Thecactusman0/Music32-V3/Music32v3/3D models/Batt connector.step

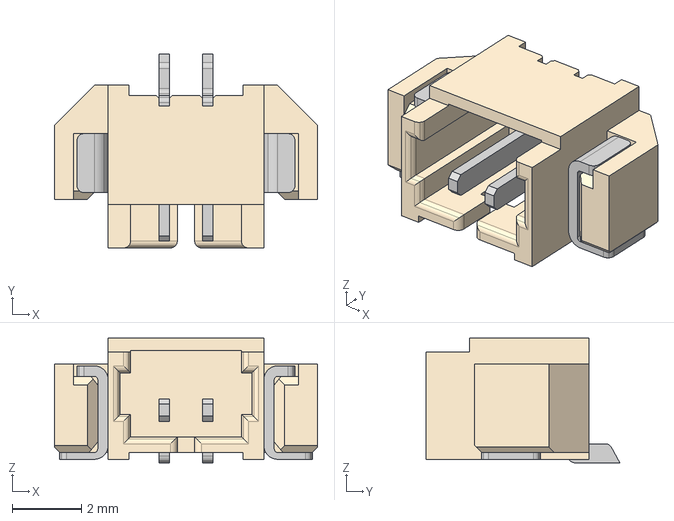
[picture p1: CAD file, 2023-12-19]
Music32v3/3D models/Batt connector.step
7.60 x 5.60 x 3.60 mm
