Thecactusman0/Music32-V3/Music32v3/3D models/srgp400200 copy.stp

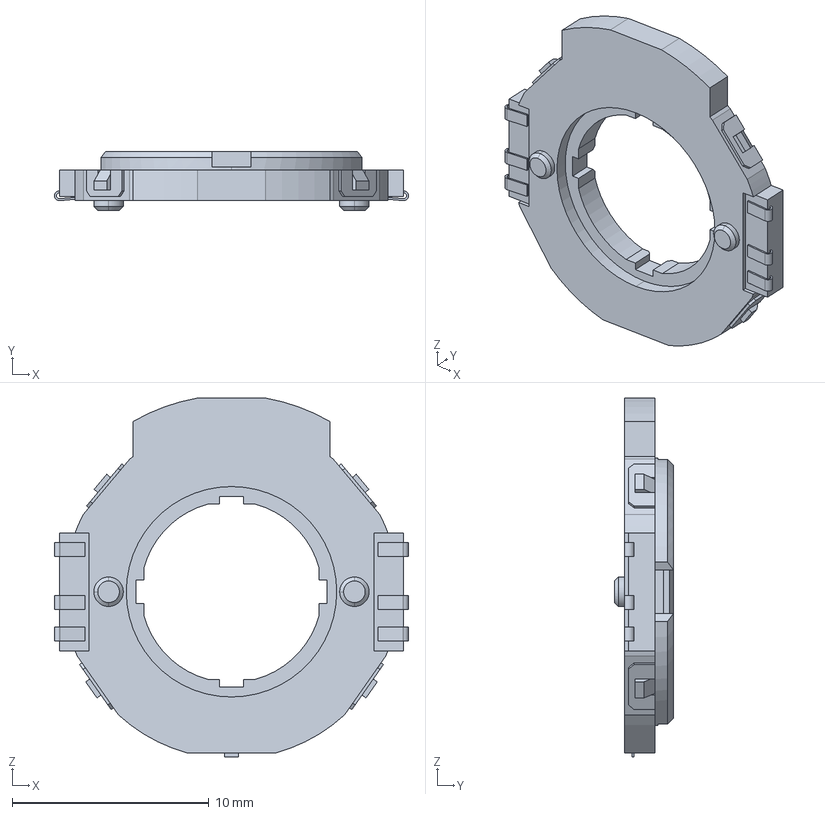
[picture p2: CAD file, 2023-12-19]
Music32v3/3D models/srgp400200 copy.stp
18.0 x 3.00 x 18.2 mm
