Thecactusman0/Music32-V3/Music32v3/3D models/TS3315A.step

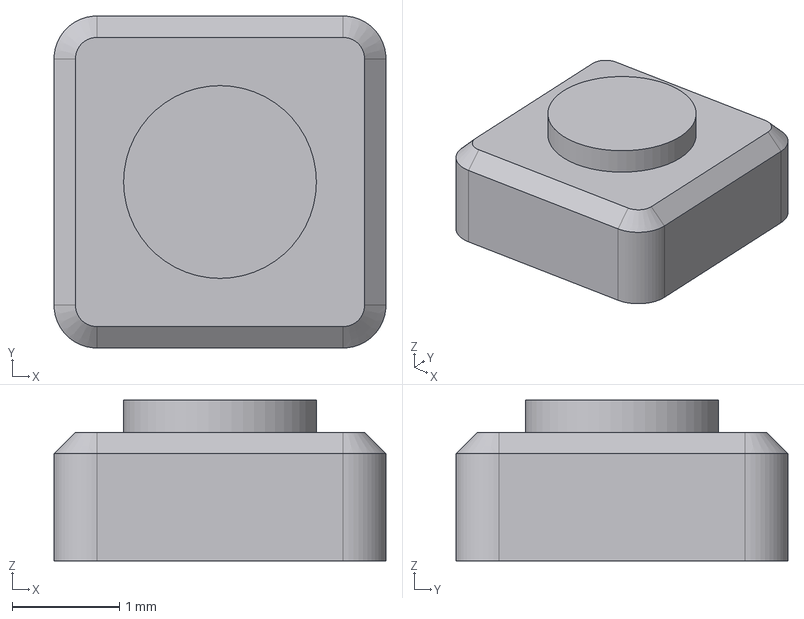
[picture p3: CAD file, 2023-11-29]
Music32v3/3D models/TS3315A.step
3.10 x 3.10 x 1.50 mm
