Thecactusman0/Music32-V3/Music32v3/3D models/TSA002A3816B04.step

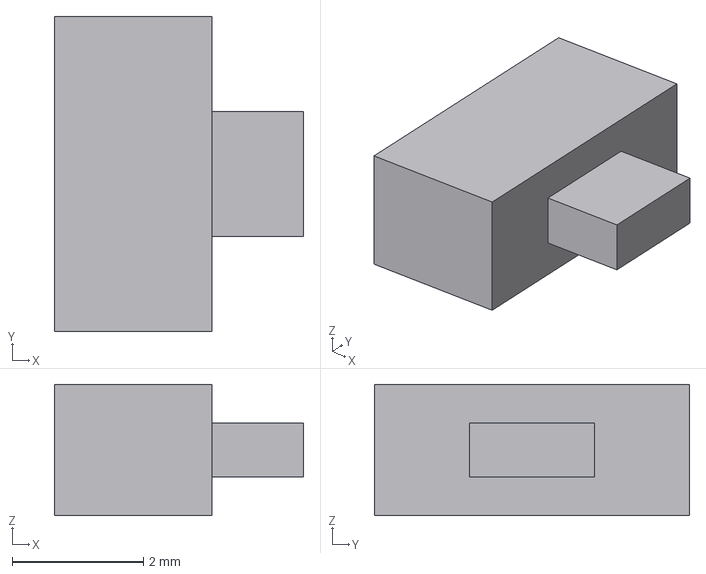
[picture p4: CAD file, 2023-11-29]
Music32v3/3D models/TSA002A3816B04.step
3.80 x 4.80 x 2.00 mm
