Thecactusman0/Music32-V3/Music32v3/3D models/2” lcd without the cable.step

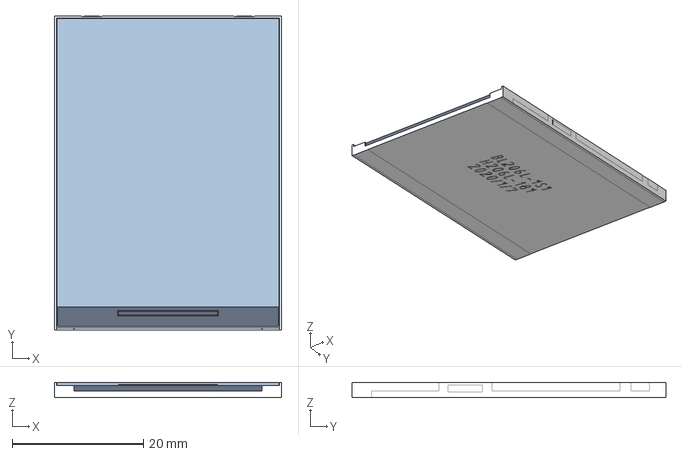
[picture p5: CAD file, 2023-11-25]
Music32v3/3D models/2” lcd without the cable.step
34.6 x 47.8 x 2.30 mm
2.0 TFT IPS - 12P - Reverse Mount - With Glass
2.0 TFT IPS - 12P - Reverse Mount - Glass
