Thecactusman0/Music32-V3/Music32v3/3D models/GMI4015P-2C-66db.step

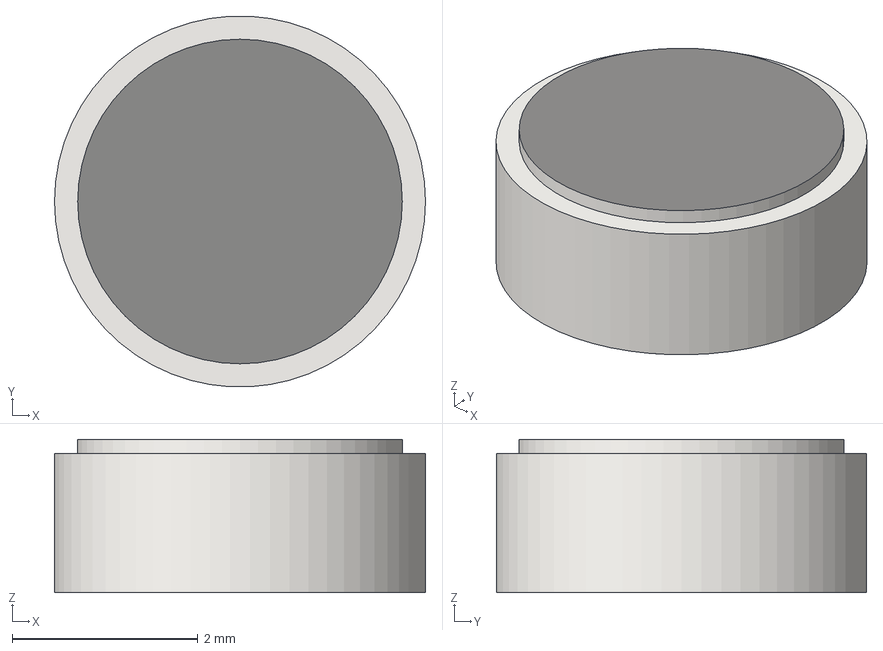
[picture p6: CAD file, 2023-11-25]
Music32v3/3D models/GMI4015P-2C-66db.step
4.00 x 3.99 x 1.65 mm
