Thecactusman0/Music32-V3/Music32v3/3D models/2.0 TFT IPS - 12P - Reverse Mount - With Glass.stp

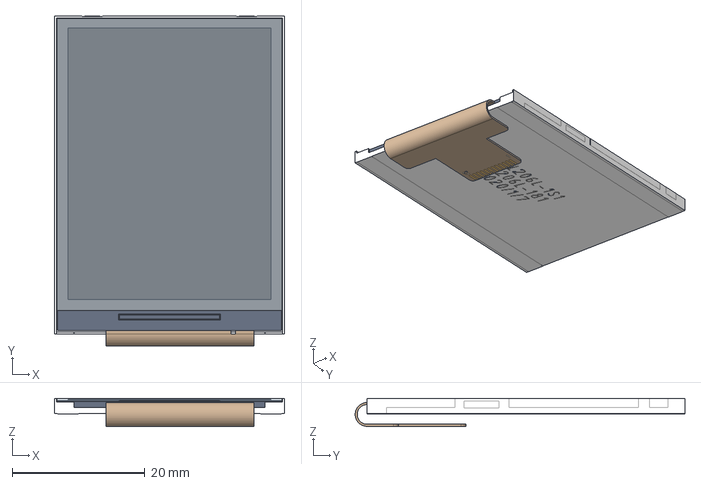
[picture p7: CAD file, 2023-11-25]
Music32v3/3D models/2.0 TFT IPS - 12P - Reverse Mount - With Glass.stp
34.6 x 49.6 x 4.22 mm
2.0 TFT IPS - 12P - Reverse Mount - With Glass
2.0 TFT IPS - 12P - Reverse Mount - Glass
