Thecactusman0/Music32-V3/Music32v3/3D models/Audio socket.step

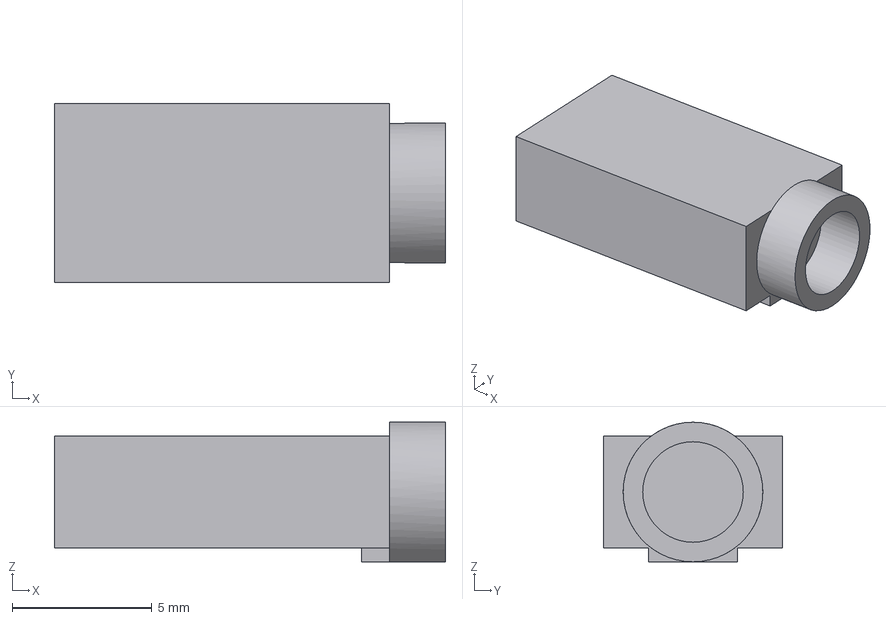
[picture p8: CAD file, 2023-11-25]
Music32v3/3D models/Audio socket.step
14.0 x 6.40 x 5.00 mm
