Thecactusman0/Music32-V3/Music32v3/3D models/SK-3393M-G1.step

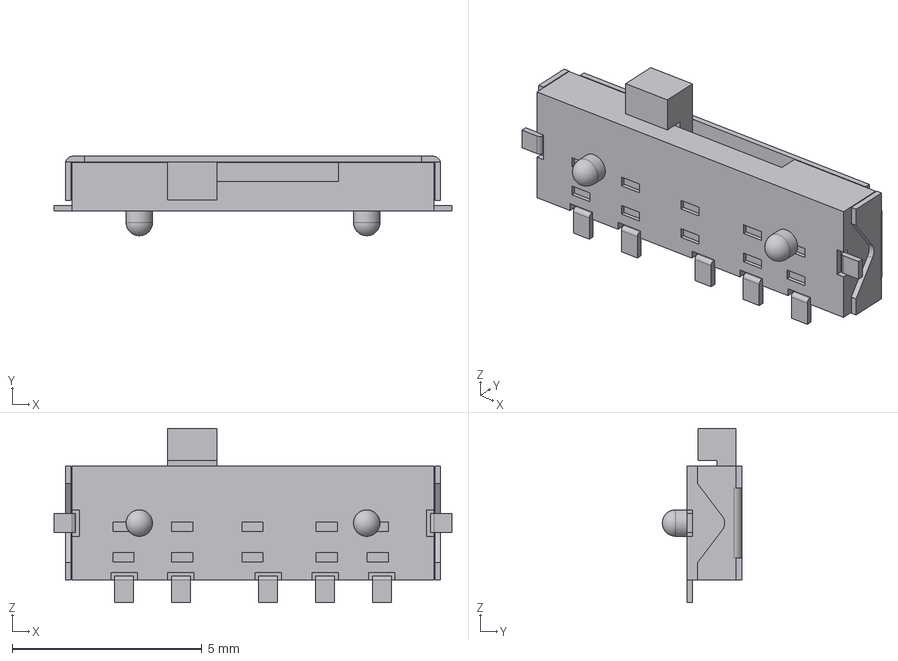
[picture p9: CAD file, 2023-11-25]
Music32v3/3D models/SK-3393M-G1.step
10.5 x 2.10 x 4.60 mm
