Thecactusman0/Music32-V3/Music32v3/3D models/u262-16xn-4bvc11.stp

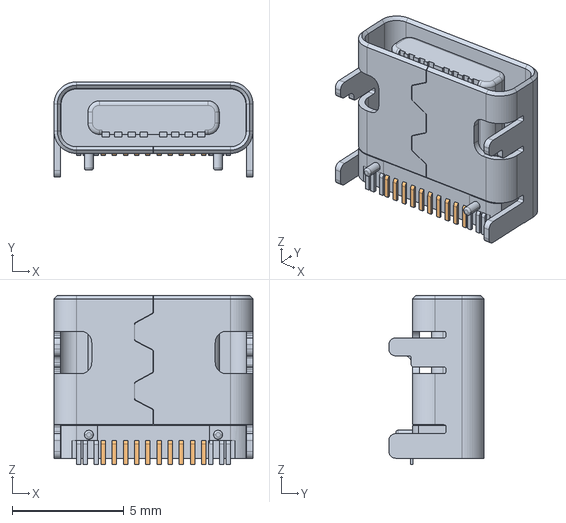
[picture p10: CAD file, 2023-11-25]
Music32v3/3D models/u262-16xn-4bvc11.stp
8.90 x 4.26 x 7.56 mm
