Thecactusman0/Music32-V3/Music32v3/3D models/ESP32-WROOM-32E.step

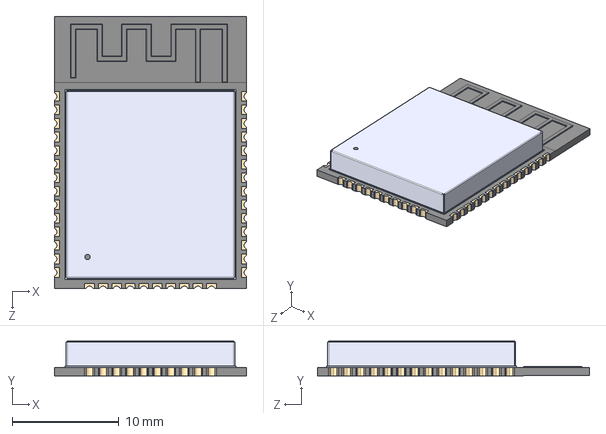
[picture p11: CAD file, 2023-11-21]
Music32v3/3D models/ESP32-WROOM-32E.step
18.0 x 3.25 x 25.5 mm
