Thecactusman0/Music32-V3/Music32v3/3D models/503398-1892.step

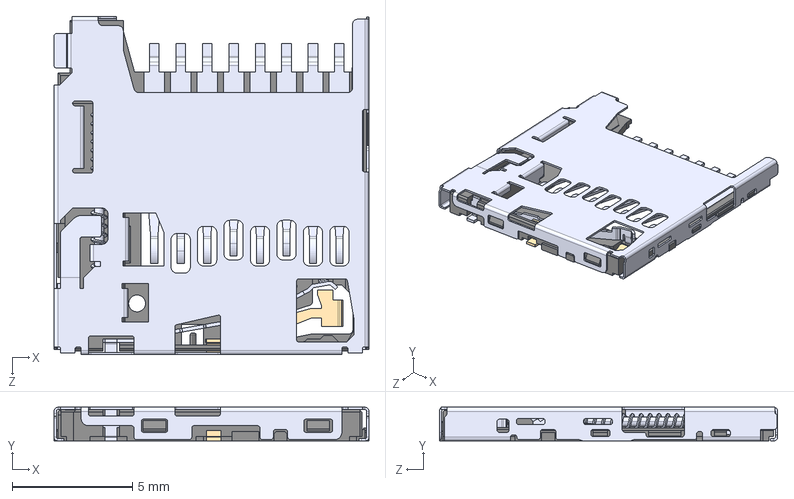
[picture p12: CAD file, 2023-11-27]
Music32v3/3D models/503398-1892.step
13.1 x 1.40 x 14.1 mm
