Thecactusman0/Music32-V3/Music32v3/3D models/MAX17048G+.STEP

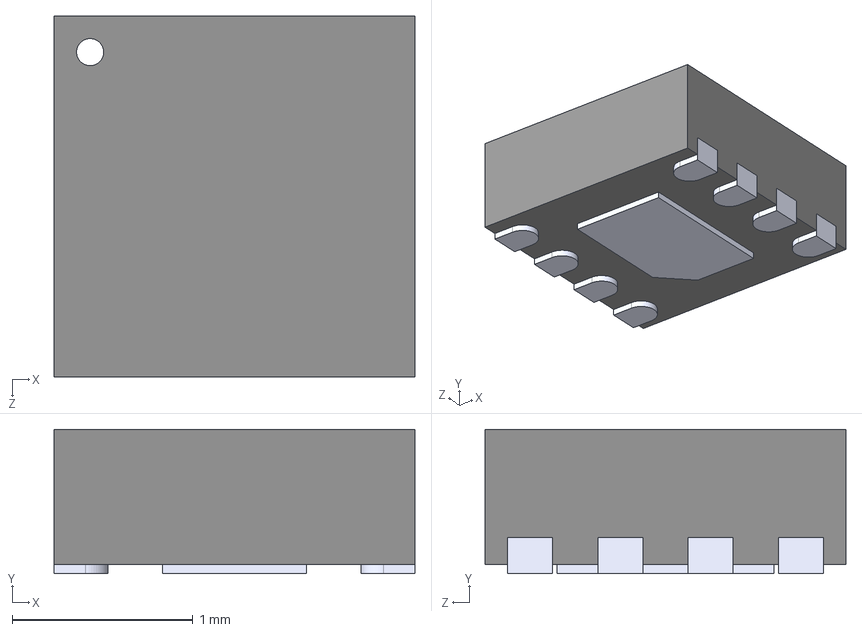
[picture p13: CAD file, 2023-11-25]
Music32v3/3D models/MAX17048G+.STEP
2.00 x 0.8 x 2.00 mm
