Thecactusman0/Music32-V3/(list of files, cad)

Other CAD files:
Music32v3/3D models/Encoder v3.step
Music32v3/3D models/Encoder.stl
