Thecactusman0/Music32-V3/Music32v3/Music32v3.pdf

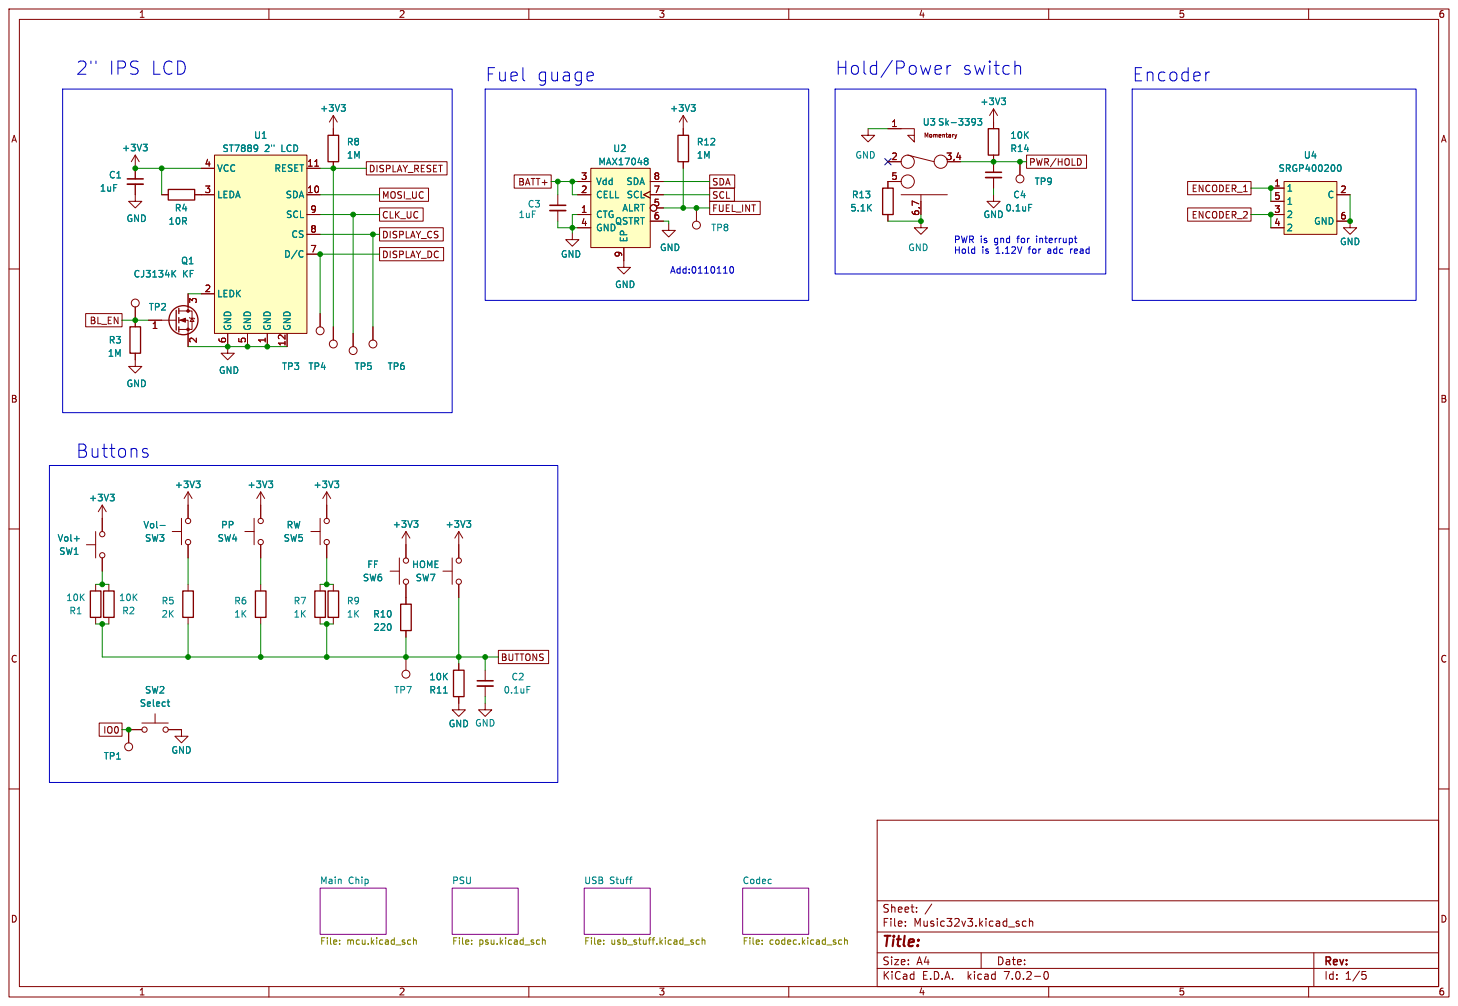
[picture p14: page 1]

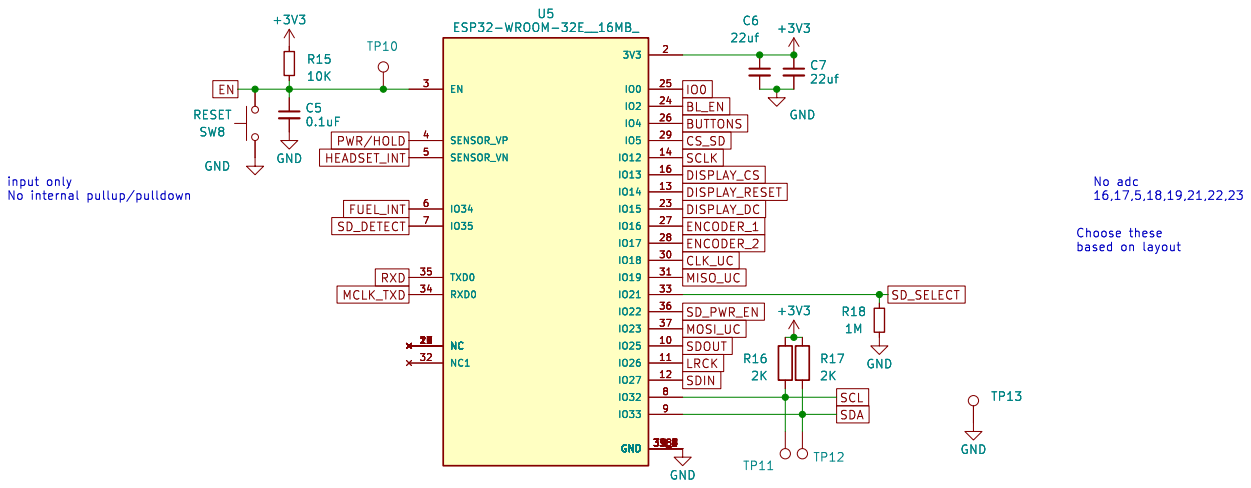
[picture p15: page 2]

based on layout GND

Id: 2/5 Title: File: mcu.kicad_sch Sheet: /Main Chip/

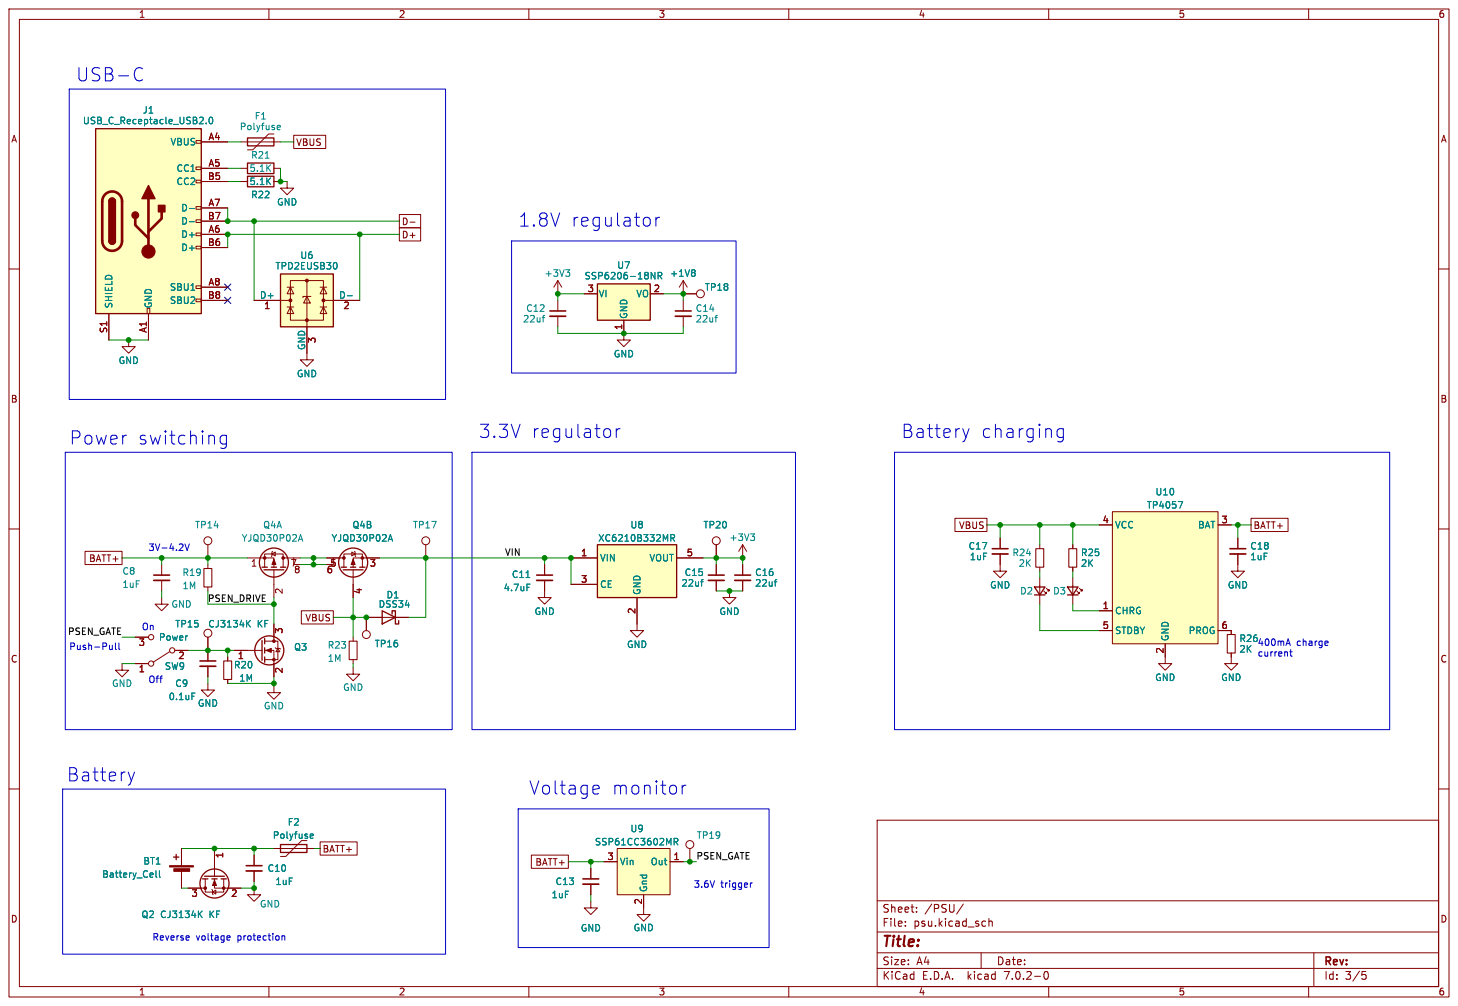
[picture p16: page 3]

2 BAT 3 VCC 4 STDBY 5 PROG 6 U10 TP4057 R26

2 BAT 3 VCC 4 STDBY 5 PROG 6GND

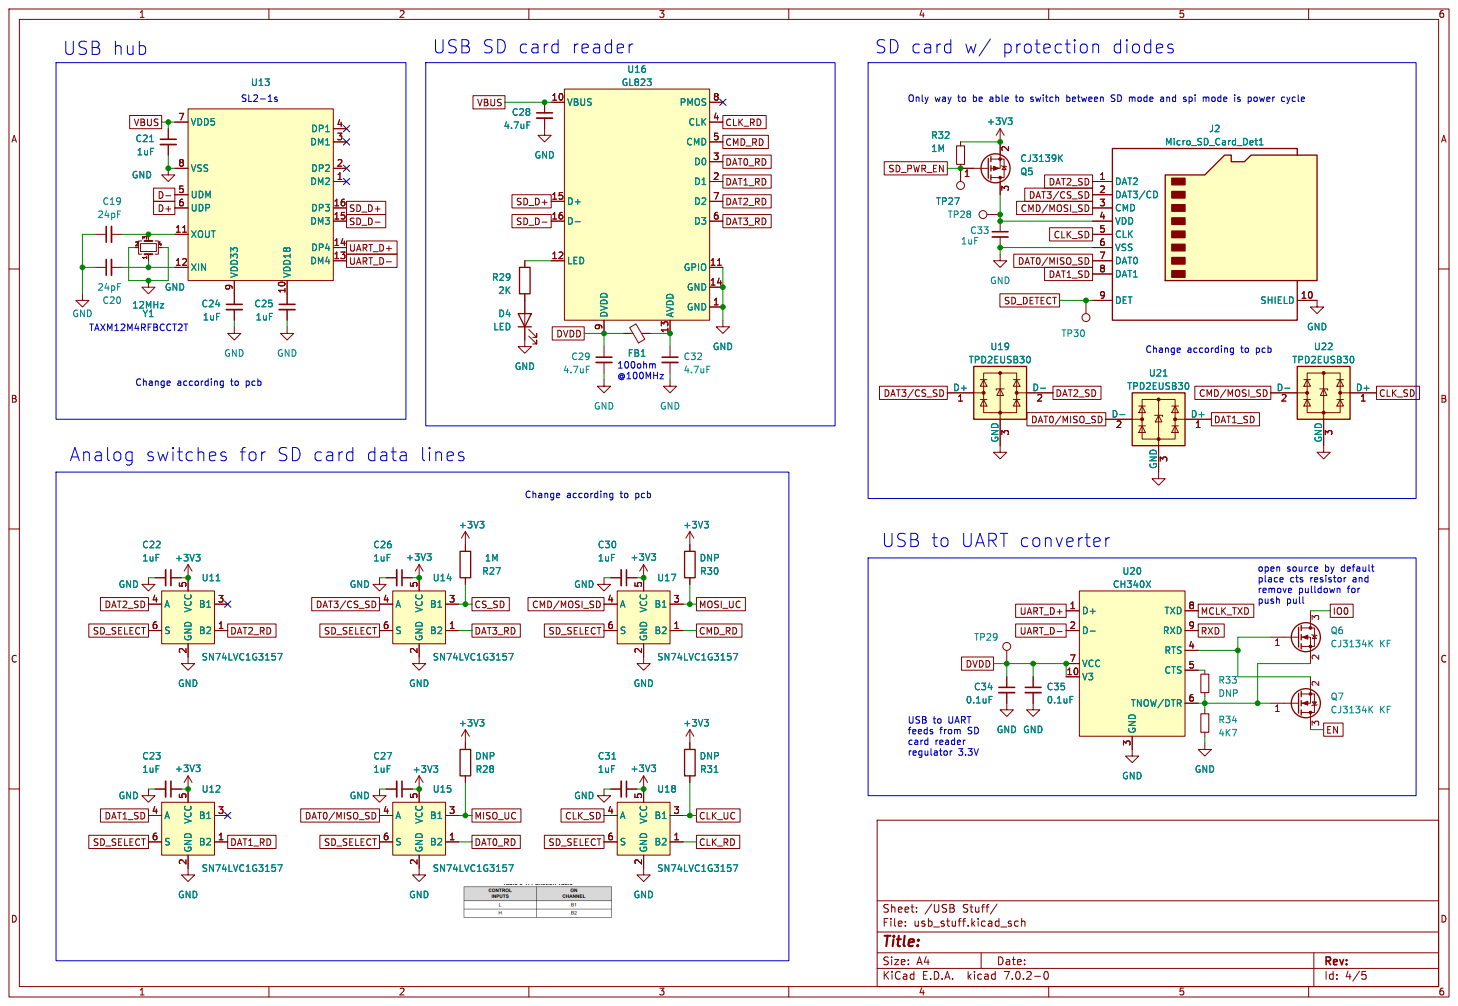
[picture p17: page 4]

DAT1_SD Only way to be able to switch between SD mode and spi mode is power cycle

Analog switches for SD card data lines

USB to UART converter

3 RTS 4 CTS 5 TNOW/DTR 6 VCC 7 TXD 8 RXD 9 U20 CH340X GND

3 RTS 4 CTS 5 TNOW/DTR 6 VCC 7 TXD 8 RXD 9GND GND

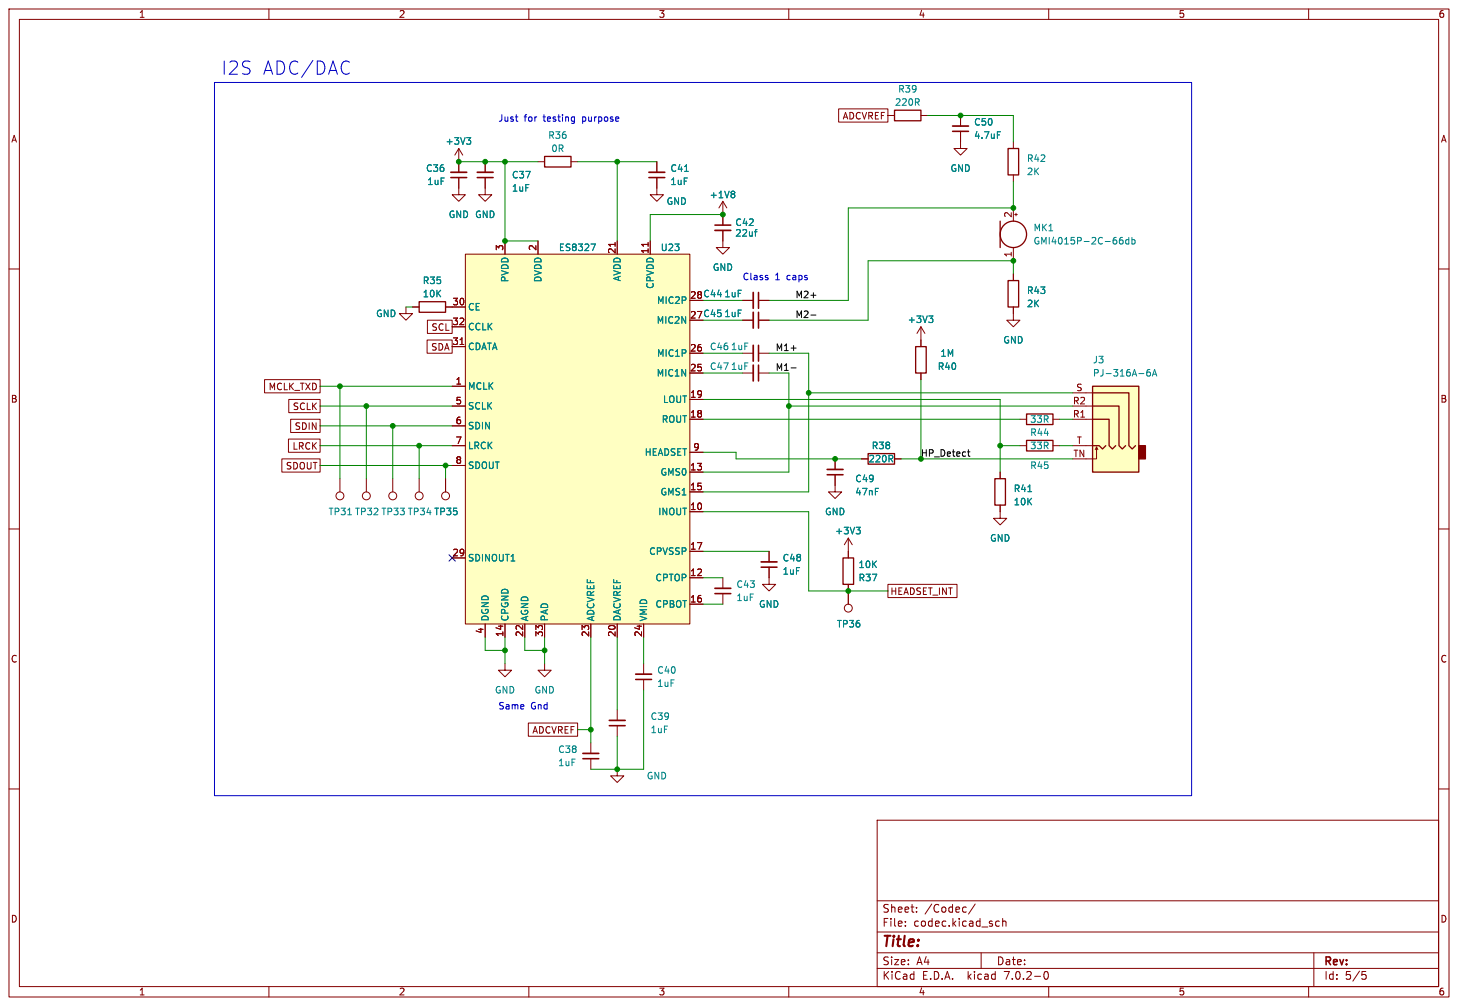
[picture p18: page 5]

2 DACVREF 20 AVDD 21 AGND 22 ADCVREF 23 VMID 24 MIC1N 25 MIC1P 26 MIC2N 27 MIC2P 28 SDINOUT1 29 PVDD

3 CE 30 CDATA 31 CCLK 32 PAD 33 DGND

1uF GND
Id: 5/5 Title: File: codec.kicad_sch Sheet: /Codec/ GND
