Thecactusman0/Music32-V3/Music32v3/Music32v3.kicad_pcb

## KiCad design Music32v3/Music32v3.kicad_pcb (2023-12-19)

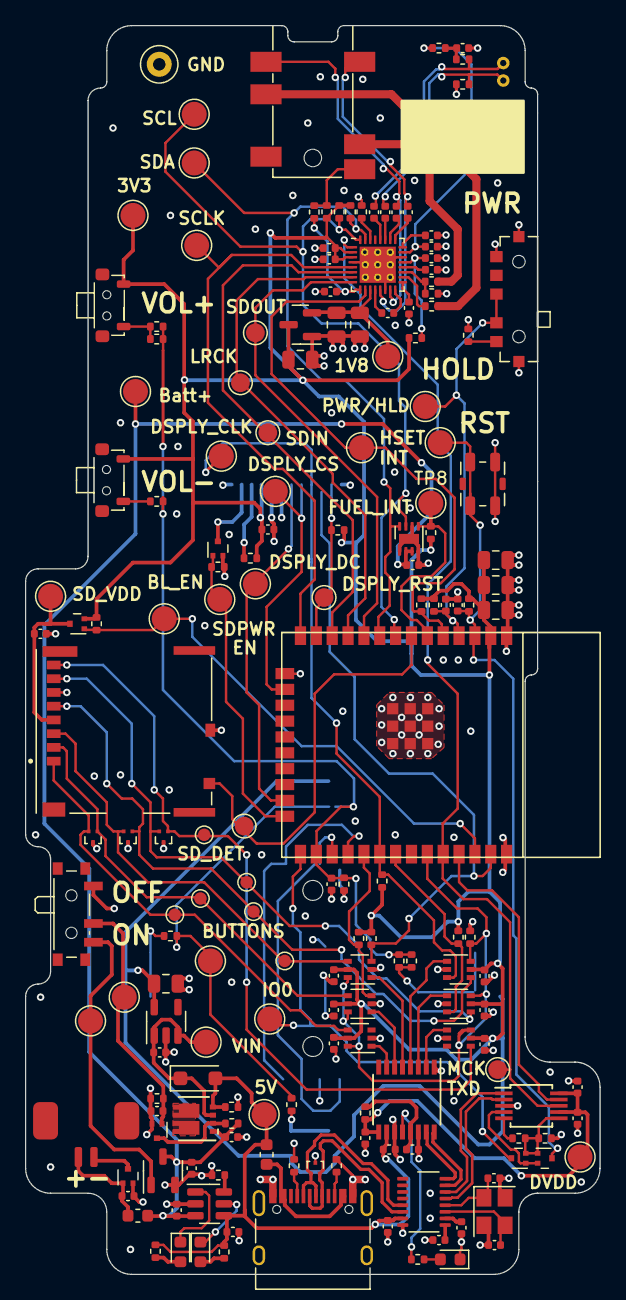
[picture p19: board Music32v3.kicad_pcb from above]

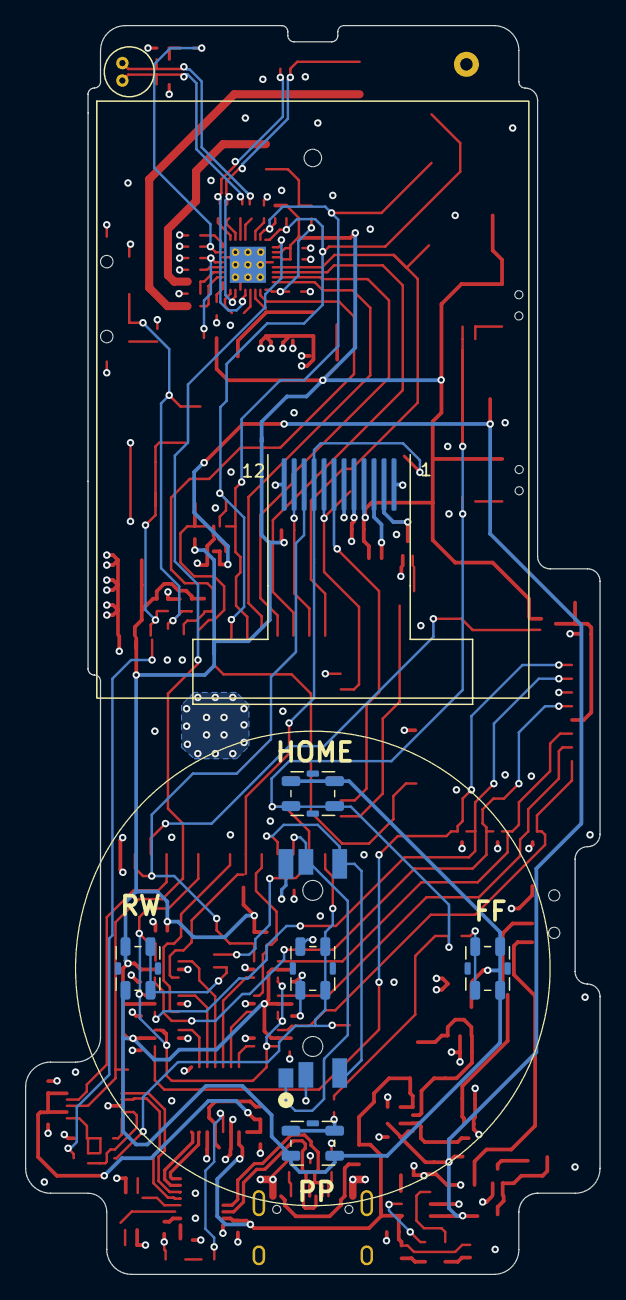
[picture p20: board Music32v3.kicad_pcb from below]

Board: 4 copper layers, 46.0 x 100.0 mm, 183 parts (8 on the bottom side), 108 nets.

Parts:
BT1: Battery_Cell; HCZZ0001-2
C1, C3, C8, C10, C13, C17, C18, C21, C22, C23, C24, C25, C26, C27, C30, C31, C33, C36, C37, C38, C39, C40, C41, C43, C44, C45, C46, C47, C48: 1uF; C_0402_1005Metric
C2, C4, C5, C9, C34, C35: 0.1uF; C_0402_1005Metric
C6, C7, C12, C14, C15, C16, C42: 22uf; C_0805_2012Metric
C11, C28, C29, C32, C50: 4.7uF; C_0402_1005Metric
C19, C20: 24pF; C_0402_1005Metric
C49: 47nF; C_0402_1005Metric
D1: DSS34; D_SOD-123F
D2, D3: LED_Small; LED_0603_1608Metric
D4: LED; LED_0603_1608Metric
F1, F2: Polyfuse; Fuse_0603_1608Metric
FB1: 100ohm@100MHz; R_0402_1005Metric
J1: USB_C_Receptacle_USB2.0; U263-163N-4OS1735
J2: Micro_SD_Card_Det1; MOLEX_503398-1892
J3: PJ-316A-6A
MK1: GMI4015P-2C-66db
Q1, Q2, Q3, Q6, Q7: CJ3134K KF; SOT-723
Q4: YJQD30P02A; YJQD30P02A_DFN3.3x3.3
Q5: CJ3139K; SOT-723
R1, R2, R11, R14, R15, R35, R37, R41: 10K; R_0402_1005Metric
R3, R8, R12, R18, R19, R20, R23, R27, R32, R40: 1M; R_0402_1005Metric
R4: 10R; R_0402_1005Metric
R5, R16, R17, R24, R25, R26, R29, R42, R43: 2K; R_0402_1005Metric
R6, R7, R9: 1K; R_0402_1005Metric
R10: 220; R_0402_1005Metric
R13, R21, R22: 5.1K; R_0402_1005Metric
R28, R30, R31, R33: DNP; R_0402_1005Metric
R34: 4K7; R_0402_1005Metric
R36: 0R; R_0402_1005Metric
R38, R39: 220R; R_0402_1005Metric
R44, R45: 33R; R_0402_1005Metric
SW1: Vol+; TSA002A3816B04
SW2: Select; TS3315A
SW3: Vol-; TSA002A3816B04
SW4: PP; TS3315A
SW5: RW; TS3315A
SW6: FF; TS3315A
SW7: HOME; TS3315A
SW8: RESET; TS3315A
SW9: Power; SW_SPDT_PCM12
TP1, TP2, TP3, TP5, TP6, TP7, TP8, TP9, TP10, TP11, TP12, TP14, TP15, TP16, TP17, TP18, TP19, TP20, TP27, TP28, TP29, TP32, TP36: TestPoint; TestPoint_Pad_D2.0mm
TP4, TP30, TP31, TP33, TP34, TP35: TestPoint; TestPoint_Pad_D1.5mm
TP13: TestPoint; TestPoint_Loop_D2.50mm_Drill1.0mm
TP21, TP22, TP23, TP24, TP25, TP26: TestPoint; TestPoint_Pad_D1.0mm
U1: ST7889 2" LCD; TFT020-2_same_side
U2: MAX17048; DFN-8-1EP_2x2mm_P0.5mm_EP0.8x1.6mm
U3: Sk-3393; SK-3393M-G1
U4: SRGP400200; SRGP400200_ALPS
U5: ESP32-WROOM-32E__16MB_; ESP32-WROOM-32E
U6, U19, U21, U22: TPD2EUSB30; Texas_DRT-3
U7: SSP6206-18NR; SOT-23
U8: XC6210B332MR; SOT-23-5
U9: SSP61CC3602MR; SOT-23-3
U10: TP4057; SOT-23-6
U11, U12, U14, U15, U17, U18: SN74LVC1G3157; SOT-363_SC-70-6
U13: SL2.1S
U16: GL823; SSOP-16_3.9x4.9mm_P0.635mm
U20: CH340X; MSOP-10_3x3mm_P0.5mm
U23: ES8327; QFN-32-1EP_4x4mm_P0.4mm_EP2.9x2.9mm_ThermalVias
Y1: 12MHz; Crystal_SMD_3225-4Pin_3.2x2.5mm

Connections:
+1V8: C14.1, C42.1, TP18.1, U7.2 (VO), U23.11 (CPVDD)
+3V3: C1.1, C6.1, C7.1, C12.1, C15.1, C16.1, C22.1, C23.1, C26.1, C27.1, C30.1, C31.1, C36.2, C37.2, Q5.2 (S), R4.1, R8.2, R12.2, R14.1, R15.1, R16.1, R17.1, R27.1, R28.1, R30.1, R31.1, R32.2, R36.1, R37.1, R40.1, SW1.2, SW3.2, SW4.2, SW5.2, SW6.2, SW7.2, TP20.1, U1.4 (VCC), U5.2 (3V3), U7.3 (VI), U8.5 (VOUT), U11.5 (VCC), U12.5 (VCC), U14.5 (VCC), U15.5 (VCC), U17.5 (VCC), U18.5 (VCC), U23.2 (DVDD), U23.3 (PVDD)
/Codec/HP_Detect: J3.TN, R38.1, R40.2
/Codec/M1+: C46.1, J3.S, U23.15 (GMS1)
/Codec/M1-: C47.1, J3.R2, U23.13 (GMS0)
/Codec/M2+: C44.1, MK1.2 (+), R42.2
/Codec/M2-: C45.1, MK1.1 (-), R43.1
/PSU/PSEN_DRIVE: Q3.3 (D), Q4.2 (G2), R19.1
/PSU/PSEN_GATE: SW9.3 (C), TP19.1, U9.1 (Out)
/PSU/VIN: C11.1, D1.1 (K), Q4.3 (S2), TP17.1, U8.1 (VIN), U8.3 (CE)
ADCVREF: C38.2, R39.1, U23.23 (ADCVREF)
BATT+: C3.1, C8.1, C13.1, C18.1, F2.2, Q4.1 (S2), R19.2, TP14.1, U2.2 (CELL), U2.3 (Vdd), U9.3 (Vin), U10.3 (BAT)
BL_EN: Q1.1 (G), R3.2, TP2.1, U5.24 (IO2)
BUTTONS: C2.1, R1.1, R2.1, R5.2, R6.2, R7.2, R9.2, R10.2, R11.2, SW7.1, TP7.1, U5.26 (IO4)
CLK_RD: U16.4 (CLK), U18.1 (B2)
CLK_SD: J2.5 (CLK), TP24.1, U18.4 (A), U22.1 (D+)
CLK_UC: R31.2, TP5.1, U1.9 (SCL), U5.30 (IO18), U18.3 (B1)
CMD_RD: U16.5 (CMD), U17.1 (B2)
CMD/MOSI_SD: J2.3 (CMD), TP23.1, U17.4 (A), U22.2 (D-)
CS_SD: R27.2, U5.29 (IO5), U14.3 (B1)
D+: J1.A6 (D+), J1.B6 (D+), U6.2 (D-), U13.6 (UDP)
D-: J1.A7 (D-), J1.B7 (D-), U6.1 (D+), U13.5 (UDM)
DAT0_RD: U15.1 (B2), U16.3 (D0)
DAT0/MISO_SD: J2.7 (DAT0), TP25.1, U15.4 (A), U21.2 (D-)
DAT1_RD: U12.1 (B2), U16.2 (D1)
DAT1_SD: J2.8 (DAT1), TP26.1, U12.4 (A), U21.1 (D+)
DAT2_RD: U11.1 (B2), U16.7 (D2)
DAT2_SD: J2.1 (DAT2), TP21.1, U11.4 (A), U19.2 (D-)
DAT3_RD: U14.1 (B2), U16.6 (D3)
DAT3/CS_SD: J2.2 (DAT3/CD), TP22.1, U14.4 (A), U19.1 (D+)
DISPLAY_CS: TP6.1, U1.8 (CS), U5.16 (IO13)
DISPLAY_DC: TP3.1, U1.7 (D/C), U5.23 (IO15)
DISPLAY_RESET: R8.1, TP4.1, U1.11 (RESET), U5.13 (IO14)
DVDD: C29.1, C34.1, C35.1, FB1.2, TP29.1, U16.9 (DVDD), U20.7 (VCC), U20.10 (V3)
EN: C5.1, Q7.3 (D), R15.2, SW8.2, TP10.1, U5.3 (EN)
ENCODER_1: U4.1, U4.5 (1), U5.27 (IO16)
ENCODER_2: U4.3 (2), U4.4 (2), U5.28 (IO17)
FUEL_INT: R12.1, TP8.1, U2.5 (ALRT), U5.6 (IO34)
GND: C1.2, C2.2, C3.2, C4.2, C5.2, C6.2, C7.2, C8.2, C9.2, C10.2, C11.2, C12.2, C13.2, C14.2, C15.2, C16.2, C17.2, C18.2, C19.1, C20.1, C21.2, C22.2, C23.2, C24.2, C25.2, C26.2, C27.2, C28.2, C29.2, C30.2, C31.2, C32.2, C33.2, C34.2, C35.2, C36.1, C37.1, C38.1, C39.1, C40.1, C41.1, C42.2, C48.1, C49.1, C50.1, D4.1 (K), J1.A1 (GND), J1.A12 (GND), J1.B1 (GND), J1.B12 (GND), J1.S1 (SHIELD), J2.6 (VSS), J2.10 (SHIELD), Q1.2 (S), Q2.2 (S), Q3.2 (S), R3.1, R11.1, R13.1, R18.1, R20.1, R21.2, R22.2, R23.1, R26.2, R34.2, R35.1, R41.2, R43.2, SW2.2, SW8.1, SW9.1 (A), TP13.1, U1.1 (GND), U1.5 (GND), U1.6 (GND), U1.12 (GND), U2.1 (CTG), U2.4 (GND), U2.6 (QSTRT), U2.9 (EP), U3.1, U3.6,7, U4.2 (C), U4.6 (GND), U5.1 (GND), U5.15 (GND), U5.38 (GND), U6.3 (GND), U7.1 (GND), U8.2 (GND), U9.2 (Gnd), U10.2 (GND), U11.2 (GND), U12.2 (GND), U13.8 (VSS), U14.2 (GND), U15.2 (GND), U16.1 (GND), U16.11 (GPIO), U16.14 (GND), U17.2 (GND), U18.2 (GND), U19.3 (GND), U20.3 (GND), U21.3 (GND), U22.3 (GND), U23.4 (DGND), U23.14 (CPGND), U23.22 (AGND), U23.33 (PAD), Y1.2, Y1.4
HEADSET_INT: R37.2, TP36.1, U5.5 (SENSOR_VN), U23.10 (INOUT)
IO0: Q6.3 (D), SW2.1, TP1.1, U5.25 (IO0)
LRCK: TP34.1, U5.11 (IO26), U23.7 (LRCK)
MCLK_TXD: TP31.1, U5.34 (RXD0), U20.8 (TXD), U23.1 (MCLK)
MISO_UC: R28.2, U5.31 (IO19), U15.3 (B1)
MOSI_UC: R30.2, U1.10 (SDA), U5.37 (IO23), U17.3 (B1)
unnamed: BT1.2 (+), C10.1, F2.1, Q2.1 (G)
unnamed: C50.2, R39.2, R42.1
unnamed: D2.2 (A), R24.2
unnamed: D2.1 (K), U10.5 (STDBY)
unnamed: D3.2 (A), R25.2
unnamed: D3.1 (K), U10.1 (CHRG)
unnamed: D4.2 (A), R29.2
unnamed: F1.1, J1.A4 (VBUS), J1.A9 (VBUS), J1.B4 (VBUS), J1.B9 (VBUS)
unnamed: J1.A5 (CC1), R21.1
unnamed: J1.B5 (CC2), R22.1
unnamed: C33.1, J2.4 (VDD), Q5.3 (D), TP28.1
unnamed: J3.R1, R44.2
unnamed: J3.T, R45.2
unnamed: Q1.3 (D), U1.2 (LEDK)
unnamed: BT1.1, Q2.3 (D)
unnamed: C9.1, Q3.1 (G), R20.2, SW9.2 (B), TP15.1
unnamed: Q4.5 (D2), Q4.6 (D2), Q4.7 (D2), Q4.8 (D2)
unnamed: Q6.1 (G), Q7.2 (S), U20.4 (RTS)
unnamed: Q6.2 (S), Q7.1 (G), R33.2, R34.1, U20.6 (TNOW/DTR)
unnamed: R1.2, R2.2, SW1.1
unnamed: R5.1, SW3.1
unnamed: R6.1, SW4.1
unnamed: R7.1, R9.1, SW5.1
unnamed: R10.1, SW6.1
unnamed: R13.2, U3.5
unnamed: R4.2, U1.3 (LEDA)
unnamed: R26.1, U10.6 (PROG)
unnamed: C25.1, U13.10 (VDD18)
unnamed: C24.1, U13.9 (VDD33)
unnamed: C20.2, U13.12 (XIN), Y1.1
unnamed: C19.2, U13.11 (XOUT), Y1.3
unnamed: C32.1, FB1.1, U16.13 (AVDD)
unnamed: R29.1, U16.12 (LED)
unnamed: R33.1, U20.5 (CTS)
unnamed: C41.2, R36.2, U23.21 (AVDD)
unnamed: R35.2, U23.30 (CE)
unnamed: C43.1, U23.16 (CPBOT)
unnamed: C43.2, U23.12 (CPTOP)
unnamed: C48.2, U23.17 (CPVSSP)
unnamed: C39.2, U23.20 (DACVREF)
unnamed: C49.2, R38.2, U23.9 (HEADSET)
unnamed: R41.1, R45.1, U23.19 (LOUT)
unnamed: C47.2, U23.25 (MIC1N)
unnamed: C46.2, U23.26 (MIC1P)
unnamed: C45.2, U23.27 (MIC2N)
unnamed: C44.2, U23.28 (MIC2P)
unnamed: R44.1, U23.18 (ROUT)
unnamed: C40.2, U23.24 (VMID)
PWR/HOLD: C4.1, R14.2, TP9.1, U3.3,4, U5.4 (SENSOR_VP)
RXD: U5.35 (TXD0), U20.9 (RXD)
SCL: R16.2, TP11.1, U2.7 (SCL), U5.8 (IO32), U23.32 (CCLK)
SCLK: TP32.1, U5.14 (IO12), U23.5 (SCLK)
SDA: R17.2, TP12.1, U2.8 (SDA), U5.9 (IO33), U23.31 (CDATA)
SDIN: TP33.1, U5.12 (IO27), U23.6 (SDIN)
SDOUT: TP35.1, U5.10 (IO25), U23.8 (SDOUT)
SD_D+: U13.16 (DP3), U16.15 (D+)
SD_D-: U13.15 (DM3), U16.16 (D-)
SD_DETECT: J2.9 (DET), TP30.1, U5.7 (IO35)
SD_PWR_EN: Q5.1 (G), R32.1, TP27.1, U5.36 (IO22)
SD_SELECT: R18.2, U5.33 (IO21), U11.6 (S), U12.6 (S), U14.6 (S), U15.6 (S), U17.6 (S), U18.6 (S)
UART_D+: U13.14 (DP4), U20.1 (D+)
UART_D-: U13.13 (DM4), U20.2 (D-)
VBUS: C17.1, C21.1, C28.1, D1.2 (A), F1.2, Q4.4 (G2), R23.2, R24.1, R25.1, TP16.1, U10.4 (VCC), U13.7 (VDD5), U16.10 (VBUS)
