Thecactusman0/Music32-V3/(commit log)

2023-11-21 MCU and PSU
    MCU and PSU Schem started
    [ESP32-WROOM-32E__16MB_.step, Music32v3.kicad_sch, mcu.kicad_sch, psu.kicad_sch]
2023-11-23 PSU update
    [Music32v3.kicad_sch, psu.kicad_sch, usb_stuff.kicad_sch]
2023-11-23 SD card and usb and power
    [Music32v3.kicad_sch, mcu.kicad_sch, psu.kicad_sch, usb_stuff.kicad_sch]
2023-11-25 Auto programming
    [usb_stuff.kicad_sch]
2023-11-27 PCB outline
    [503398-1892.step, Music32v3.kicad_pcb, Music32v3.kicad_sch, codec.kicad_sch, mcu.kicad_sch, psu.kicad_sch, usb_stuff.kicad_sch]
2023-11-29 Board setup
    [Music32v3.kicad_pcb, Music32v3.kicad_sch, TS3315A.step, TSA002A3816B04.step, codec.kicad_sch, mcu.kicad_sch, psu.kicad_sch, usb_stuff.kicad_sch]
2023-11-29 Button placement fix
    [Music32v3.kicad_pcb]
2023-12-03 pcb done
    [Music32v3.csv, Music32v3.kicad_pcb, usb_stuff.kicad_sch]
2023-12-11 pdf schematic
    [Music32v3.kicad_pcb, mcu.kicad_sch]
2023-12-19 remade the encoder 3d model
    made it not mesh
    [Encoder v3.step]
2023-12-19 Pcb changes
    [usb_stuff.kicad_sch]
2023-12-19 Fixed 3d models
    [Batt connector.step, Music32v3.kicad_pcb, srgp400200 copy.stp]
2023-12-19 Fixed resistor
    [Music32v3.kicad_sch]
